SohaNiroomand/Discrete-BJT-Audio-Power-Amplifier/Elec2_Report_Ph2_403170569_English.pdf

Electronics II Project Report: Phase II – Soha Niroomand

# Design and Evaluation Report for the Electronics II Project (Phase II)

Name: Soha Niroomand Student ID: 403170569

## 1 Project Requirements

### Main Phase-II Requirements

In this phase, the completed amplifier must be designed and evaluated as a single integrated circuit containing a differential input stage, voltage-amplification stages, bias networks, a power output stage, the output load, and global negative feedback. The final circuit must satisfy the following requirements:

Required Value | Parameter
50Ω | Output load resistance (RL)
18 ≤ |Av,closed| ≤ 22 Closed-loop gain at 1 kHz
10kΩ to 200kΩ | Allowed range of Rf and Rg
16Vpp | Main output swing without severe clipping
> 60% | Output-stage efficiency at 16Vpp
< 0.08% | THD under normal conditions
< 1% | THD in the presence of the specified noise sources
≤ 190mW | Total power at 50mV and 1 kHz input
> 1MΩ | Differential input resistance (Rin,diff)
< 50Ω | Output resistance (Rout), with RL removed
10mV | Sawtooth supply ripple in the PSRR test
≤ 200 | Maximum circuit cost

### Final Specification Check

The final measured results are summarized below. All main tests were performed on the complete feedback amplifier with RL = 50Ω, except for the output-resistance test, in which the load was removed as required.

Parameter | Requirement | Measured Value | Status
|Av,closed| | 18 to 22 | 20.877 | PASS
Vout,pp | at least 16Vpp | 16.050Vpp | PASS
ηout | > 60% | 63.33% | PASS
Ptotal at 50mV input | ≤ 190mW | 163.759mW | PASS
Normal THD | < 0.08% | 0.040374% | PASS
THD with noise | < 1% | 0.819073% | PASS
PSRR | report the value | 45.429dB | –
Rin,diff | > 1MΩ | 32.479MΩ | PASS
Rout | < 50Ω | 0.2135Ω | PASS
Cost | ≤ 200 | 190 | PASS

## 2 Final Circuit and Overall Architecture

### Required Work (Part 1)

Introduce the final project circuit and state that only one complete final amplifier is submitted. The circuit must include the differential input, voltage-amplification stages, bias circuits, power output stage, RL = 50Ω load, and global negative-feedback network. Also explain the order of completion: first adding the output stage and then closing the global feedback loop.

### Selected Final Architecture

The final design is a multistage amplifier powered from symmetric ±10V supplies and implemented as one integrated circuit. Its overall structure consists of the input differential pair Q1–Q2, active loads and current mirrors, voltage-amplification stages Q6 through Q10, bias networks, a complementary class-AB output stage, and a resistive global-feedback network.
The output stage is formed by the complementary emitter followers Q13 and Q16 and is driven and biased by Q10, Q11, Q12, Q17, and Q18. The bias voltage between the two output-transistor bases is set close to two base-emitter drops, thereby reducing crossover distortion. The 50Ω load is connected directly to the final output node.
The output voltage is sampled by Rf = 200kΩ and returned to the base of Q1. Resistor Rg = 10kΩ connects the same node to ground, while the external input is applied to the base of Q2; therefore, the overall configuration is non-inverting. The power output stage was connected and biased first, and the global feedback loop was closed only after the output stage had been adjusted.
A compensation capacitor C1 = 82pF was placed around the Q10 voltage-amplification stage to improve loop stability and suppress undesired high-frequency components. Compared with Phase I, the principal additions are the power stage, the class-AB bias network, the 50Ω load, global negative feedback, and Miller compensation.

### Complete Final Schematic

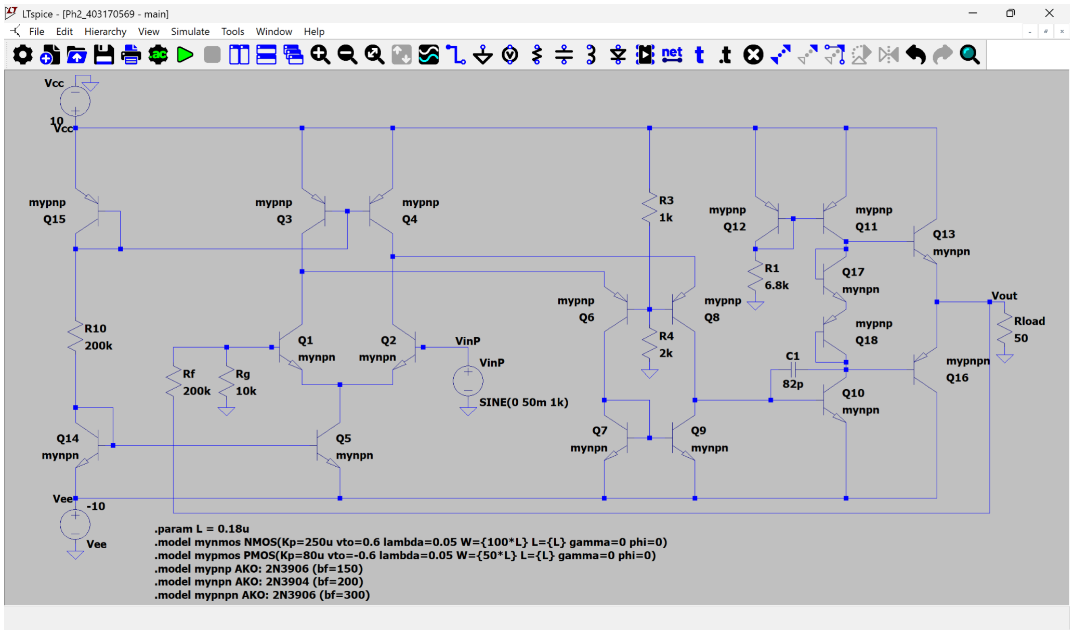
[picture p1: figure]

Figure 1 – Complete final schematic including the power stage, 50Ω load, global feedback, and the 82pF compensation capacitor.

The principal final values are Rf = 200kΩ, Rg = 10kΩ, R1 = 6.8kΩ, R3 = 1kΩ, R4 = 2kΩ, R10 = 200kΩ, and C1 = 82pF.

## 3 DC Analysis and Biasing of the Final Circuit

### Required Work (Part 2)

Perform a DC analysis of the final circuit. Evaluate the operating points of the principal stages, the bias currents, important node voltages, and the output-stage bias condition. If a VBE multiplier or an equivalent network is used, report its bias voltage.

### Theoretical Bias Calculations

The operating-point analysis was performed with zero input and a 50Ω load. From the DC results, the reference current in the left branch is

IR10 = 94.06 µA.

The tail current of the differential pair, supplied by Q5, is approximately 101.35 µA and is divided as
IC,Q1 = 53.64 µA, IC,Q2 = 47.24 µA. The small mismatch is caused by input bias currents and the closed-loop offset.
For the middle bias network,

IR3 =

10 − 6.667
1k
= 3.333 mA, | IR4 =
| 6.667 2k = 3.333 mA.

The output-stage bias branch current through R1 is approximately

IR1 = 1.373 mA.

At the operating point, the two output-drive node voltages are

VBUP = 0.8025V, VBDN = −0.5277V,

and hence the bias voltage across the output-transistor bases is

Vbias = VBUP − VBDN = 1.3302V.

This is close to two base-emitter junction drops and therefore establishes class-AB operation.
The output offset is Vout,DC = 119.087mV . With the 50Ω load, the DC load current is

IRL,DC =

0.119087
50

= 2.382mA.

The output-transistor collector currents at the operating point are

IC,Q13 = 3.158mA, |IC,Q16| = 0.779mA.

Their difference supplies the DC current delivered to the load.

### DC Operating-Point Simulation Results

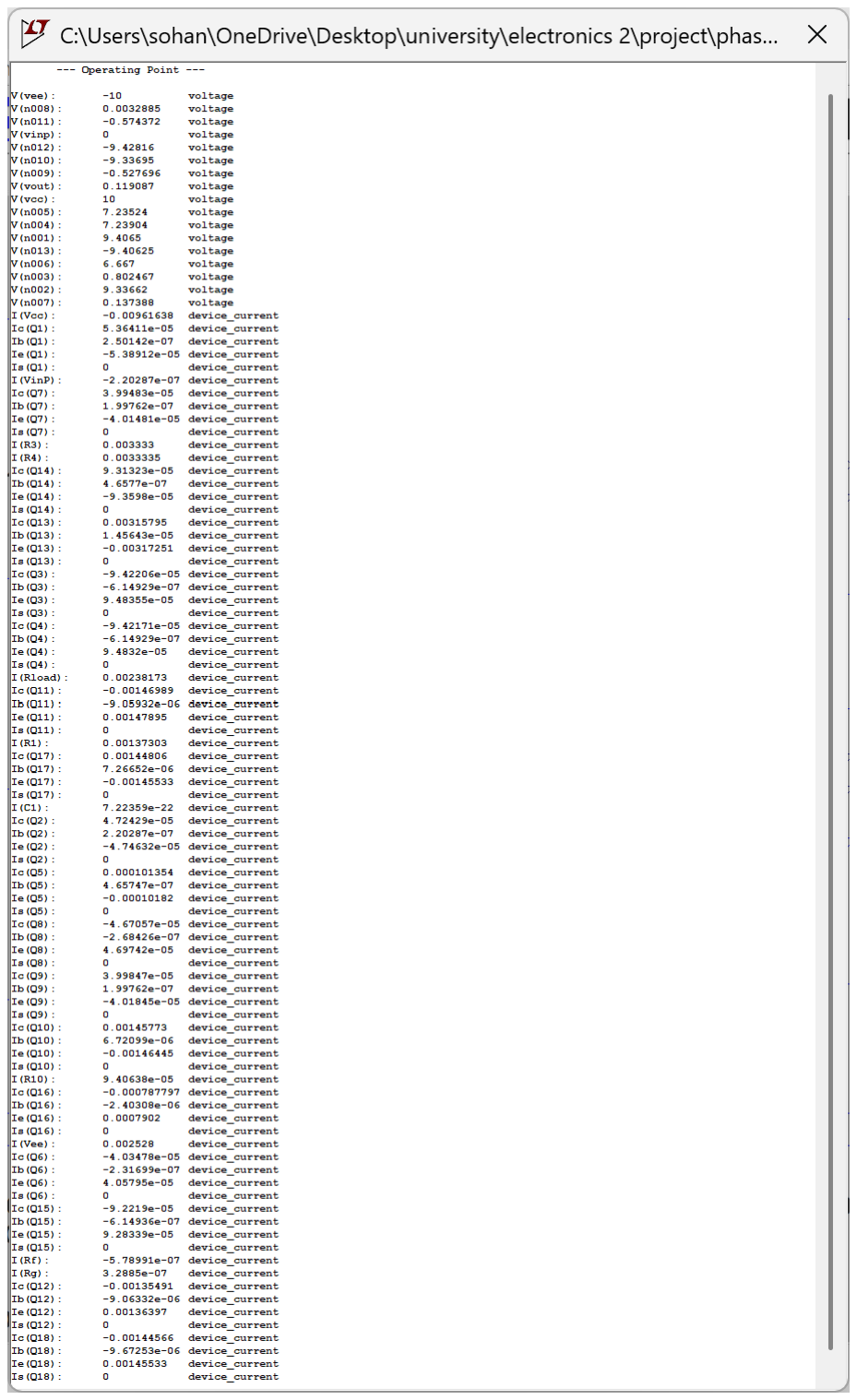
[picture p2: figure]

Figure 2 – LTspice DC operating-point results for the final circuit with zero input.

Important results:

- Output DC voltage at zero input: Vout,DC = 0.119087V .
- Quiescent output-transistor currents: IC,Q13 = 3.158mA and |IC,Q16| = 0.779mA.
- DC load current: 2.382mA.
- Output-stage bias voltage: 1.330V .
- Positive-supply current at the operating point: approximately 9.616mA; negativerail branch current: approximately 2.528mA.

All gain-stage transistors operate in their active regions. The two-junction output bias creates a small overlap in conduction around the zero crossing and reduces crossover distortion. The approximately 119mV output offset does not violate any mandatory specification.

## 4 Power Output-Stage Design

### Required Work (Part 3)

Introduce and analyze the power output stage. Show that it is connected integrally to the main amplifier and is designed to drive the 50Ω load. Explain its topology, transistor types, biasing, and the reasons for selecting this structure.

### Theoretical Output-Stage Analysis

To generate a 16Vpp output across 50Ω, the required voltage and current peaks are

Vp =

16
2

= 8V, IL,p =

Vp
RL

=

8
50

= 160mA.

The corresponding RMS voltage and theoretical load power are

VL,rms =

8
√
2

= 5.657V, PL =

V

2
L,rms
50

= 0.64W.

A complementary emitter-follower stage was selected because it provides high current gain, low output resistance, and a voltage swing close to the supply rails. The theoretical maximum efficiency of an ideal class-B sinusoidal stage is

ηB,max =

π
4

× 100% = 78.5%.

In practice, class-AB quiescent current, base-emitter drops, and driver losses reduce the attainable efficiency.
Assuming a current gain of approximately 200, the worst-case output-transistor peak base current is

IB,p ≃

160mA
200

= 0.8mA,

which can be supplied by the driver network with its approximately 1.4mA bias current.

### Output-Stage Structure and Evaluation

The output stage is a complementary class-AB push-pull emitter follower. Q13 is the upper NPN device and Q16 is the lower PNP device; their emitters are joined at Vout. The stage has approximately unity voltage gain but provides the current required by the low-resistance load.
The voltage-amplification-stage output is conveyed through Q10 and the Q11–Q12 current mirror to the Q17–Q18 bias network. This network establishes approximately 1.33V between the bases of Q13 and Q16, thereby reducing the crossover dead zone. The output PNP device uses a 2N3906-based model with βF = 300, which is within the permitted use of one different transistor model.
Capacitor C1 = 82pF is connected between the input and output of the inverting Q10 voltage-amplification stage and acts as a Miller compensation capacitor. It lowers loop gain before non-dominant poles introduce excessive phase lag, thereby improving phase margin, transient damping, and overall stability. The driver network was also designed to preserve sufficient voltage headroom for an approximately ±8V output and sufficient base current for the 160mA load-current peak.

### Mathematical Design and Selection of the Miller Compensation Capacitor

The capacitor C1 is connected between the base and collector of Q10. Since this is an inverting gain stage, let its small-signal voltage gain be

A2 =

vc10

vb10

< 0.

The current drawn by the capacitor from the input side is

iC = C1

d(vb10 − vc10)
dt | = C1(1 − A2)

dvb10
dt .

Therefore, by Miller’s theorem, the effective capacitance seen at the input of the voltage-amplification stage is approximately

CM,in = C1(1 − A2) ≃ C1(1 + |A2|),

whereas the effective capacitance at the output side is approximately

CM,out = C1

(
1 −

1
A2

)
≃ C1.

Consequently, the dominant pole associated with the input of Q10 moves to a lower frequency:

fp1 ≃

1
2πRin,V AS [Cπ,Q10 + C1(1 + |A2|)].

This produces pole splitting: around the loop crossover frequency, the loop gain is dominated by one pole and falls at approximately −20dB/dec. Thus, the loop gain reaches unity before the additional phase lag from non-dominant poles can cause ringing or oscillation.
For a first-order estimate of C1, the standard two-stage compensated-amplifier relation is used:
fu ≃

gm,in
2πC1

,

where fu is the loop unity-gain frequency and gm,in is the effective transconductance of the input stage. From the operating point,

IC,Q1 = 53.64 µA, VT ≃ 25.9mV,

so

gm,in ≃

IC,Q1
VT

=

53.64 µA
25.9mV
| = 2.07mS.

The measured closed-loop gain is ACL = 20.877. To keep the closed-loop bandwidth at roughly ten times the highest audio frequency of 20kHz, the target was selected as

fBW,CL ≃ 200kHz.

Using fBW,CL ≃ fu/ACL gives

C1,calc ≃

gm,in

2πACLfBW,CL

=

2.07mS
2π(20.877)(200kHz)

= 78.9pF.

The nearest standard and readily available value is therefore

C1 = 82pF .

With this value,
fu ≃

2.07mS
2π(82pF)

= 4.02MHz,

fBW,CL ≃

4.02MHz
20.877

= 192.5kHz.

Thus, the estimated closed-loop bandwidth is approximately 9.6 times 20kHz, which comfortably covers the audio band with little attenuation.
The compensation capacitor also limits slew rate. Using the differential-pair tail current,

Itail ≃ 101.35 µA,

the first-order available slew rate is

SRavailable ≃

Itail
C1

=

101.35 µA
82pF

= 1.24 V /µs.

For a full-amplitude sinusoid with 8V peak at 20kHz, the minimum required slew rate is

SRrequired = 2πfmaxVp = 2π(20kHz)(8V ) = 1.01 V /µs.

Therefore, 82pF still provides sufficient slew-rate margin for a full-amplitude 20kHz signal. Equivalently, the approximate maximum acceptable capacitor from the slew-rate condition is

C1,max ≃

Itail

SRrequired

= 100.8pF.

Hence, 82pF lies in a suitable range according to both bandwidth and slew-rate constraints.
The effect of changing the capacitor can be summarized as follows:
- A smaller C1 increases bandwidth and slew rate, but moves the loop crossover closer to non-dominant poles, reduces phase margin, and increases the probability of ringing, oscillation, and elevated noise-related THD.
- An excessively large C1 improves stability and attenuates high-frequency components, but reduces bandwidth, transient speed, and the ability to reproduce full-amplitude high-frequency audio signals.
- The selected 82pF value is a compromise between these effects. It yields stable transient behavior, T HD = 0.040374% without noise, and T HD = 0.819073% with the specified noise sources, while maintaining the required gain, swing, and efficiency.

## 5 Application of Global Negative Feedback

### Required Work (Part 4)

After adding the output stage, apply global negative feedback around the complete amplifier. The feedback signal must be sampled from the final output and returned to the differential input. The principal feedback network must contain only Rf and Rg, and the closed-loop gain should be approximately 20.

### Feedback-Network Calculations

The closed-loop configuration is non-inverting. Assuming sufficiently large open-loop gain,

Av,CL ≃ 1 +

Rf
Rg

With
Rf = 200kΩ, Rg = 10kΩ,

we obtain
Av,CL,ideal = 1 + | 200k 10k = 21.

Both resistors lie within the allowed 10kΩ to 200kΩ range. The feedback factor is

β =

Rg
Rf + Rg

=

1
| 21 = 0.04762.

In the standard simulation, 0.1Vpp was applied and 2.08775Vpp was measured at the output, so

|Av,CL| =

2.08775
0.1 | = 20.8775,

or
20 log10 |Av,CL| = 26.39dB.

The error relative to the ideal value is only about 0.58%.

### Feedback Results

Final values and connections:

- Rf = 200kΩ.
- Rg = 10kΩ.
- Sampling point: final Vout node, after the power stage and in the presence of the load.
- Feedback injection point: base of Q1; the base of Q2 is the signal input.
- Closed-loop gain at 1kHz: |Av| = 20.8775 or 26.39dB.

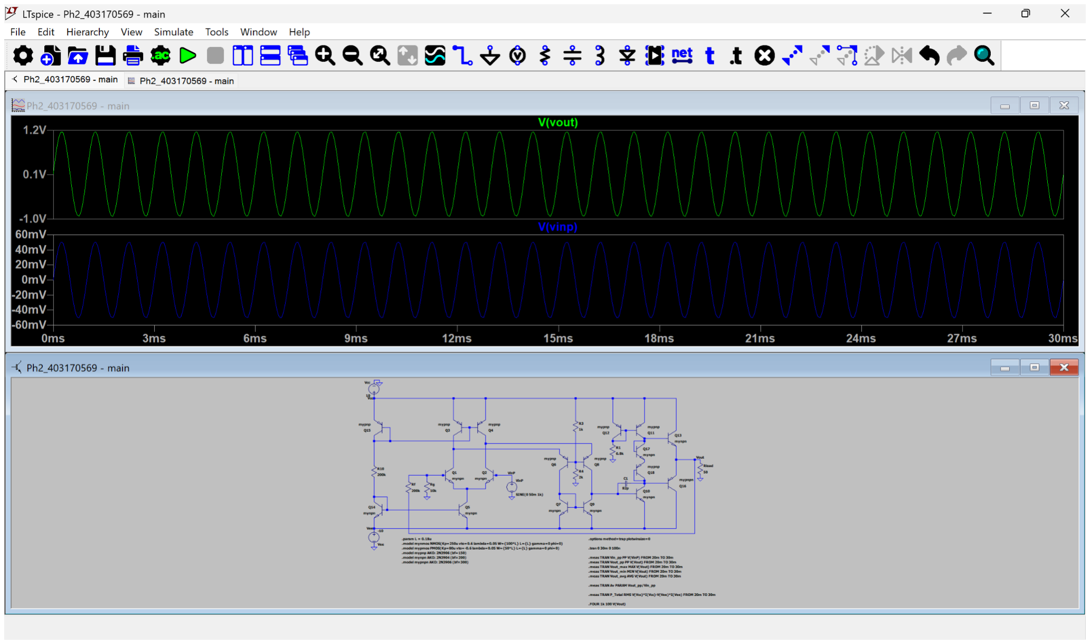
[picture p3: figure]

Figure 3 – Input and output waveforms under the standard condition: Vin = 50mVpeak and f = 1kHz.

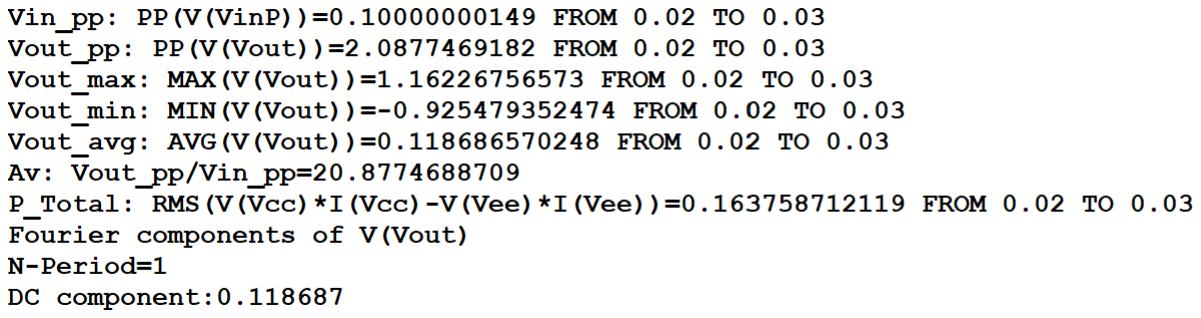
[picture p4: figure]

Figure 4 – Measured gain, output offset, and total power under the standard test condition.

The output is sinusoidal and in phase with the input, with an amplitude approximately 20.88 times larger. The measured gain lies within the permitted range of 18 to 22.

## 6 Comparison With and Without Feedback

### Required Work (Part 5)

Compare the complete circuit with global feedback and without global feedback. The output stage must remain connected in both cases. If the no-feedback circuit saturates, explain why the measured amplitude ratio is not a valid estimate of linear open-loop gain.

### Qualitative and Quantitative Comparison

For the no-feedback test, Rf and Rg were removed from the loop and the base of Q1 was connected directly to ground, while the output stage and the 50Ω load remained connected. The input in both tests was 50mVpeak at 1kHz.
With feedback, the output remains sinusoidal with Vout,pp = 2.0877V and a gain of 20.877.

Without feedback, the very large open-loop gain drives the output into saturation at approximately +9V and −9V even for this small input, producing an almost square waveform. The ratio of the saturated output amplitude to the input amplitude is not a valid estimate of linear open-loop gain because the output is limited by the supply rails.

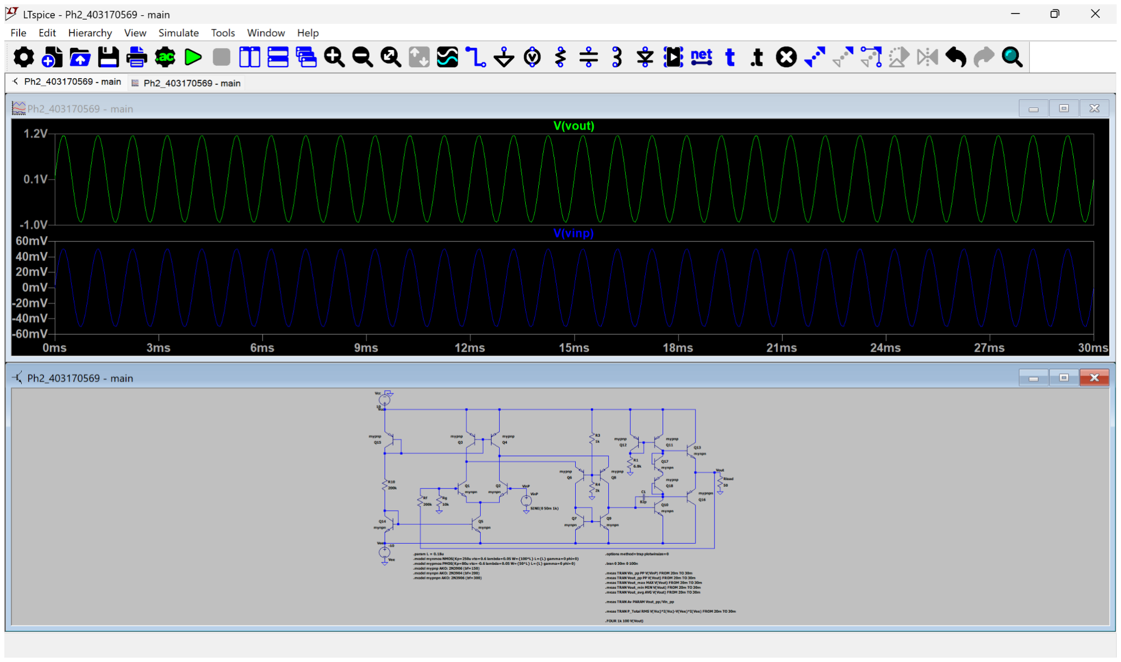
[picture p5: figure]

Figure 5 – Amplifier with feedback: linear sinusoidal output for the standard input.

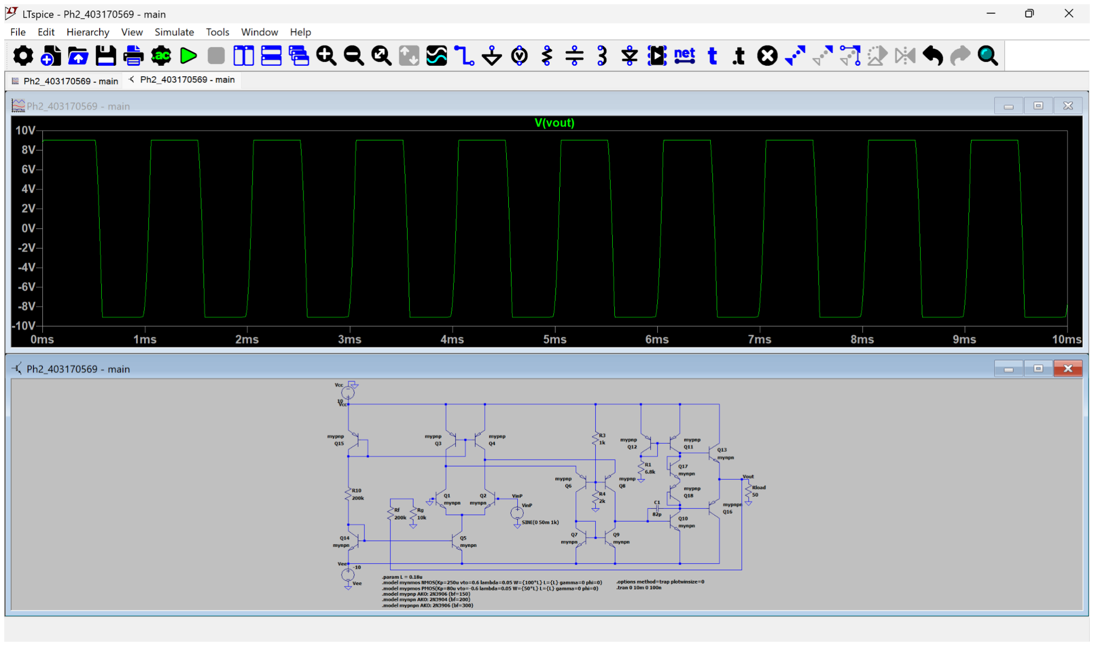
[picture p6: figure]

Figure 6 – Amplifier without feedback: severe saturation and clipping for the same input amplitude.

Negative feedback fixes the gain at a predictable value, improves linearity, reduces distortion, and increases the input amplitude required to reach clipping. Without feedback, the amplifier leaves its linear region even for a 50mV input.

## 7 Output Swing, Power, and Efficiency

### Required Work (Part 6)

Determine whether the final amplifier can produce a 16Vpp sinusoidal output across 50Ω without severe clipping or visible distortion. Then measure the load power, total circuit power, and output-stage efficiency.

### Theoretical Swing and Efficiency Calculations

With ±10V supplies, transistor and driver voltage drops imply that the output peak will be somewhat below each rail. The target Vp = 8V leaves approximately 2V of headroom from each supply and is therefore attainable with the emitter-follower topology.
For Vout,pp = 16V and RL = 50Ω,

PRL,th =

(Vpp/2√
2)²
RL

=

(16/2√
2)²
50

= 0.64W.

Because the closed-loop gain is close to 21, the theoretical required input peak is

Vin,p ≃

8
21

= 0.381V.

A value of 385mV was used in simulation. The output-stage efficiency was calculated as

ηout =

PRL

PQ13 + PQ16

× 100%.

### Transient and Power-Measurement Results

For Vin,p = 385mV at 1kHz, the results were

Vin,pp = 0.7700V,
Vout,pp = 16.0501V,
Vout,max = 8.1392V,
Vout,min = −7.9109V,
Av = 20.8443.

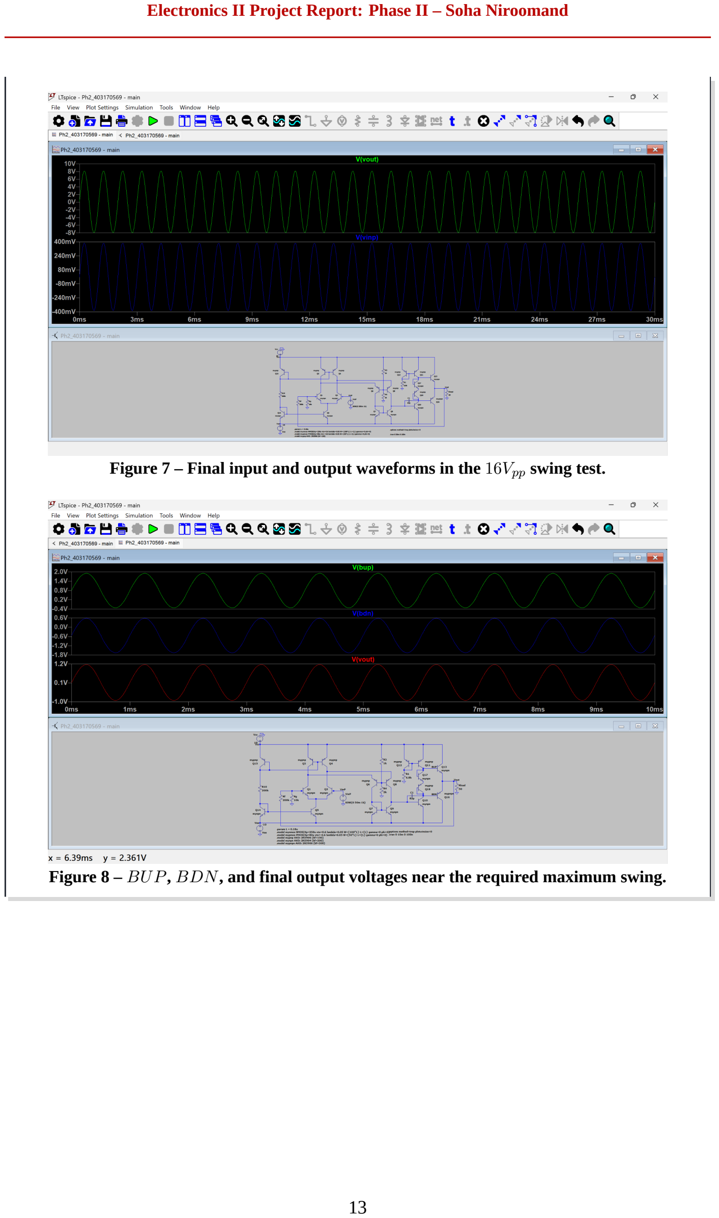
[picture p7: page 13]

Figure 7 – Final input and output waveforms in the 16Vpp swing test.

Figure 8 – BUP, BDN, and final output voltages near the required maximum swing.

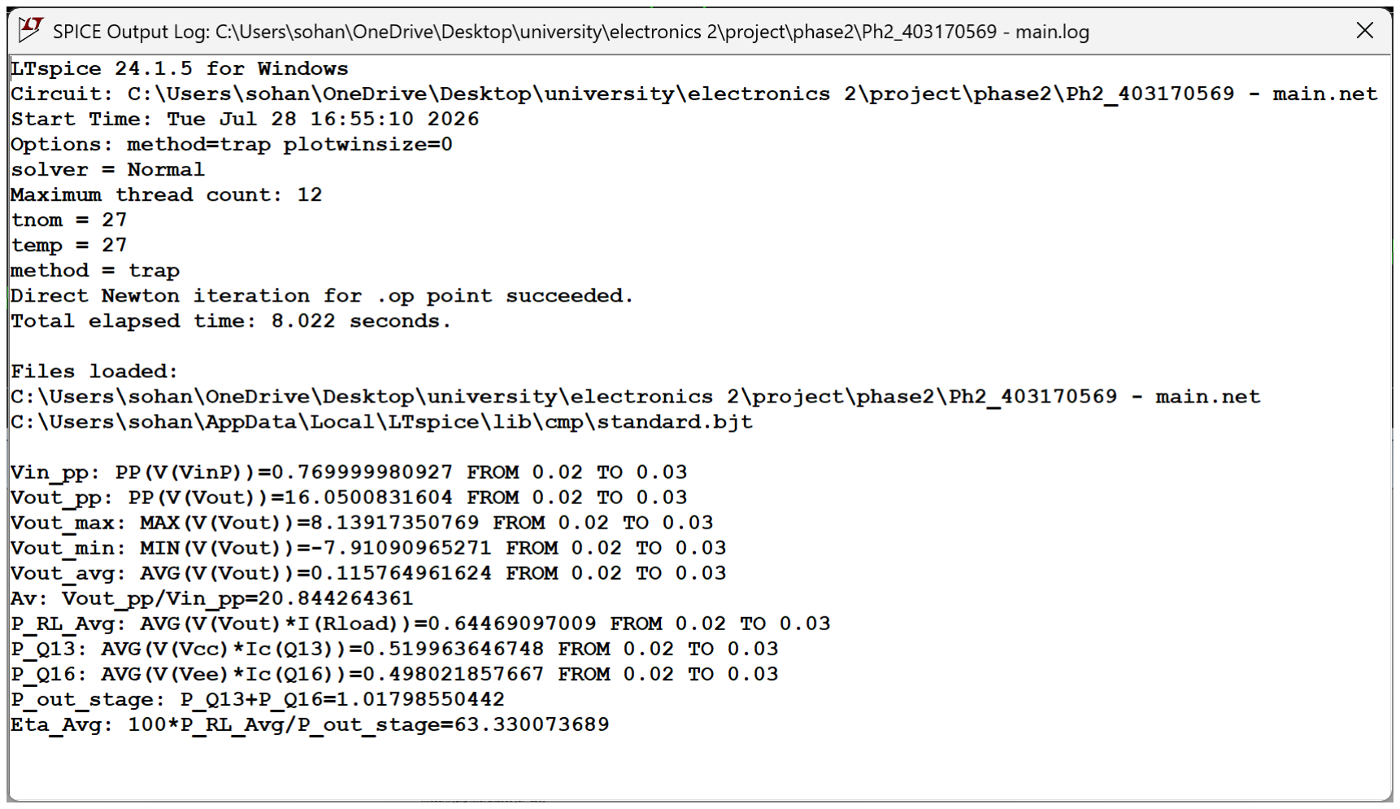
[picture p8: figure]

Figure 9 – Numerical measurements of amplitude, load power, and output-stage efficiency.

Measured values:

- Required input amplitude: 385mVpeak.
- Average load power: PRL = 0.644691W.
- Total circuit power at this operating point: Ptotal ≃ 1.138W.
- Upper output transistor power: PQ13 = 0.519964W.
- Lower output transistor power: PQ16 = 0.498022W.
- Total output-stage power: Pout−stage = 1.017986W.
- Efficiency: ηout = 63.330%, so the 60% requirement is satisfied.

The output remains essentially sinusoidal at this amplitude and no severe clipping is visible. The slight asymmetry between the positive and negative peaks is associated with the DC offset and mismatch between complementary device models. Global feedback shifts the onset of clipping to a substantially larger input amplitude than in the open-loop case. Main LTspice measurement directives:

1 | .meas TRAN Vin_pp PP V(VinP) FROM 20m TO 30m
2 | .meas TRAN Vout_pp PP V(Vout) FROM 20m TO 30m
3 | .meas TRAN P_RL_Avg AVG V(Vout)*I(Rload) FROM 20m TO 30m
4 | .meas TRAN P_Q13 AVG V(Vcc)*Ic(Q13) FROM 20m TO 30m
5 | .meas TRAN P_Q16 AVG V(Vee)*Ic(Q16) FROM 20m TO 30m
6 | .meas TRAN P_out_stage PARAM P_Q13+P_Q16
7 | .meas TRAN Eta_Avg PARAM 100*P_RL_Avg/P_out_stage

## 8 Total Power Under the Standard Input Condition

### Required Work (Part 7)

For a 50mV -peak, 1 kHz sinusoidal input, measure the total power consumed by the final circuit and compare it with
Ptotal ≤ 190mW.

### Power Measurement Under the Standard Condition

The test was performed with Vin = 50mVpeak, f = 1kHz, ±10V supplies, and RL = 50Ω. Total power was calculated from both supply rails over the steady-state interval from 20ms to 30ms.

Parameter | Value
Input amplitude | 50mVpeak
Input frequency | 1kHz
Vout,pp | 2.08775V
Total circuit power | 0.163759W = 163.759mW
Status | PASS

Figure 10 – Total circuit-power measurement for the standard input.

Since 163.759mW < 190mW, the power-consumption requirement is satisfied with approximately 26.24mW of margin.

## 9 Total Harmonic Distortion Measurement

### Required Work (Part 8)

Measure the THD of the final feedback amplifier with the output stage and 50Ω load connected. Use a 50mV -peak, 1 kHz sinusoidal input. Repeat the test after inserting the specified noise sources in series with the resistors that set the current-source values.

### Measurement Method and Interpretation

To remove start-up transients, the transient simulation was run to 30ms and Fourier analysis was performed on the steady-state waveform. The maximum time step was 100ns and waveform compression was disabled:

1 | .options method=trap plotwinsize=0
2 | .tran 0 30m 0 100n
3 | .FOUR 1k 100 V(Vout)

In the noisy test, four behavioral sources described by

1 V=(white(2e6*time)/4)

were inserted in series with R10, R3, R4, and R1. These resistors set the currents of the input current source, middle stage, and output-bias network.
The added noise randomly modulates the bias currents and creates incoherent spectral components at the output; therefore, the reported total distortion increases. Nevertheless, negative feedback suppresses part of this disturbance.

### THD Results

Test Condition | THD | Status
Feedback amplifier, no noise | 0.040374% | PASS
Feedback amplifier, with noise sources | 0.819073% | PASS

Figure 11 – Fourier table and THD of the final circuit without the added noise sources.

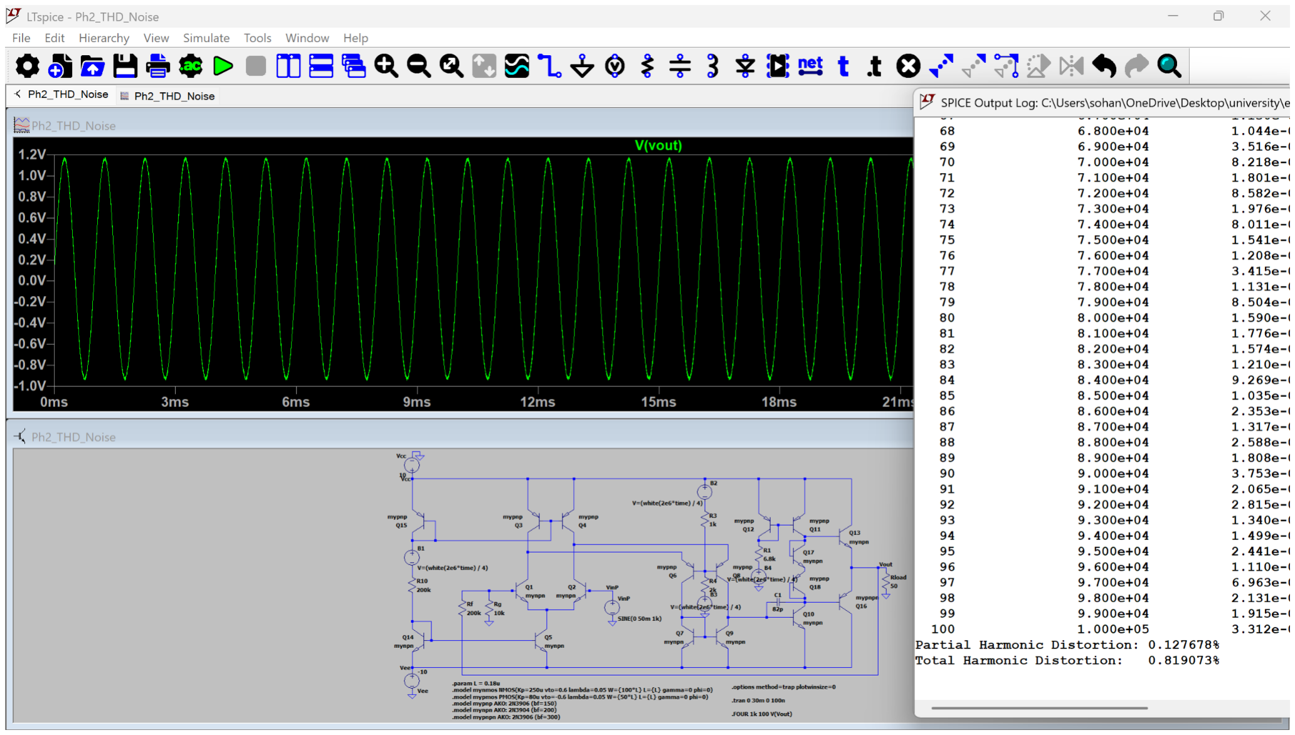
[picture p9: figure]

Figure 12 – Noisy circuit, output waveform, and measured THD = 0.819073%.

Without added noise, the second and higher harmonics are extremely small and the THD is approximately 0.0404%. With the noise sources, the total value increases to 0.8191%, which still remains below the 1% limit. In the noisy test, partial harmonic distortion was 0.127678%, while the reported total including noise components was 0.819073%.

## 10 PSRR Measurement With Sawtooth Supply Ripple

### Required Work (Part 9)

Set the signal input to zero and evaluate how supply ripple appears at the output. Use sawtooth sources with 10mV ripple for both VCC and VEE, and calculate
P SRR = 20 log (
Vripple

∆Vout)

### Test Method and PSRR Calculation

For the PSRR test, the input was set to zero and the DC supplies were replaced by

1 | PWL(0 12 5m 12.01 10m 12 15m 12.01 20m 12)
2 | PWL(0 -12 5m -12.01 10m -12 15m -12.01 20m -12)

The ripple was defined peak-to-peak, so for each rail

Vripple,pp = 10.00002mV.

The output peak-to-peak variation from 10ms to 20ms was

∆Vout,pp = 5.352497 × 10−5V = 53.525µV.

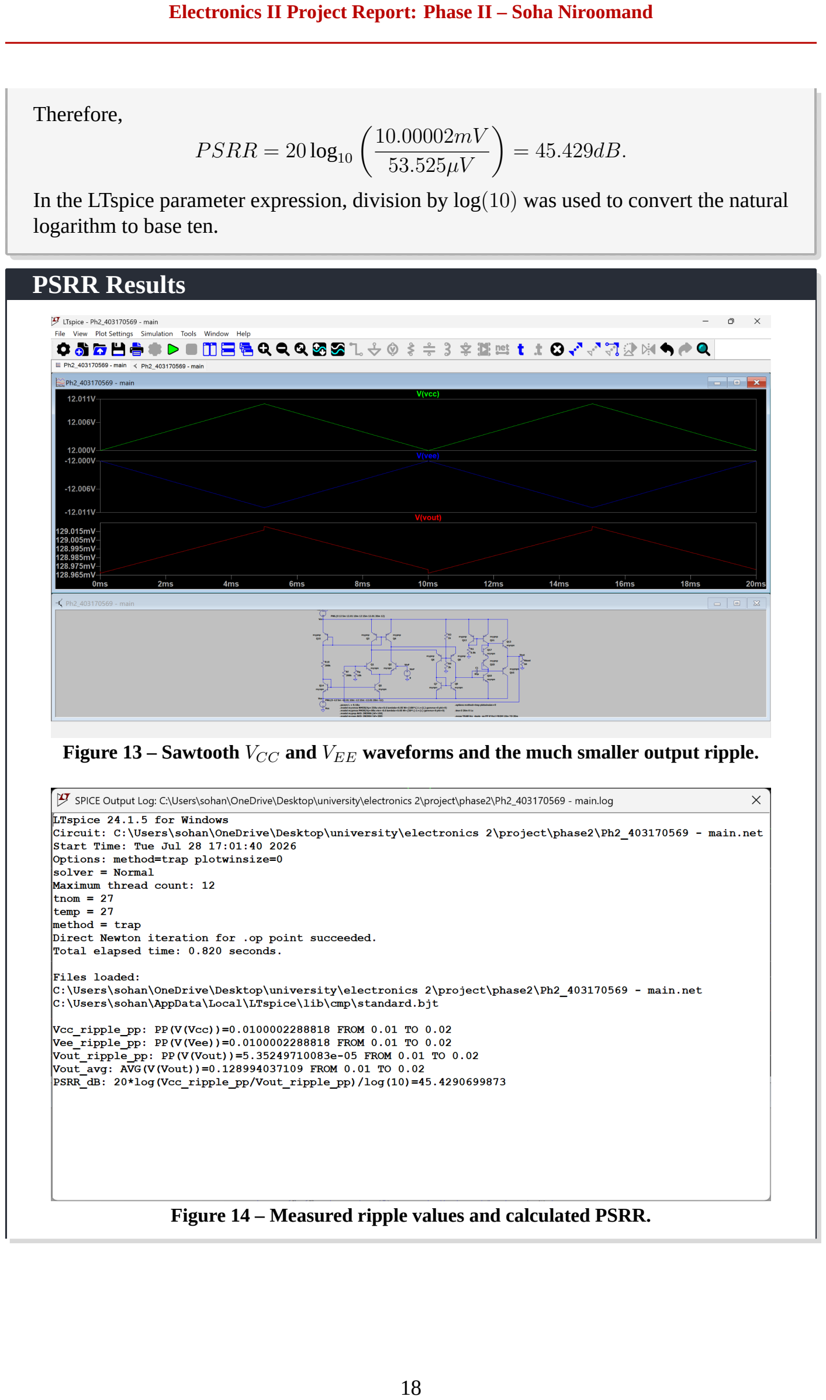
[picture p10: page 18]

Therefore,
P SRR = 20 log10 (
10.00002mV

53.525µV )
= 45.429dB.

In the LTspice parameter expression, division by log(10) was used to convert the natural logarithm to base ten.

### PSRR Results

Figure 13 – Sawtooth VCC and VEE waveforms and the much smaller output ripple.

Figure 14 – Measured ripple values and calculated PSRR.

Parameter | Value
Vripple,pp on each rail | 10.00002mV
∆Vout,pp | 53.525µV
Vout,avg | 128.994mV
PSRR | 45.429dB

The output ripple is approximately 187 times smaller than the applied ripple. Thus, at the selected ripple frequency the amplifier strongly suppresses simultaneous changes on the two supply rails. The DC output offset was excluded from the PSRR calculation; only the output peak-to-peak variation was used.

## 11 Differential Input-Resistance Measurement

### Required Work (Part 10)

Measure the differential input resistance of the final circuit and compare it with

Rin,diff > 1MΩ.

Explain the measurement procedure.

### Analytical Estimate and Measurement Method

In the small-signal model, each input transistor has an approximate base resistance

rπ =

βVT
IC

For β ≃ 200 and a collector current of roughly 47µA, the intrinsic value is approximately 110kΩ. Global negative feedback keeps the differential input voltage very small and raises the effective closed-loop input resistance by the loop-gain factor, so a value of several tens of megaohms is expected.
For the precise result, LTspice transfer-function analysis was used. LTspice calculates the small-signal input-source current and reports

Rin =

Vtest

Itest

### Input-Resistance Simulation Result

The final circuit was simulated with RL = 50Ω and zero DC input using

1 .tf V(Vout) VinP

The V inP source applies the small-signal excitation to the non-inverting input of the differential pair, while the other input is established by the feedback network.

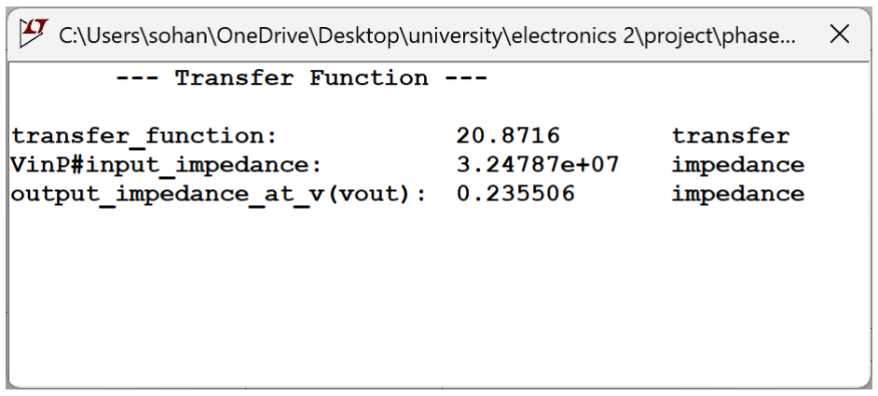
[picture p11: figure]

Figure 15 – Transfer-function result used to determine the final amplifier input resistance.

- Small-signal gain: 20.8716.
- Effective input resistance: Rin,diff = 3.24787 × 10⁷Ω = 32.4787MΩ.
- Status: PASS, because 32.4787MΩ > 1MΩ.

## 12 Output-Resistance Measurement

### Required Work (Part 11)

Remove RL, measure the final circuit output resistance, and compare it with

Rout < 50Ω.

Explain how the value is extracted from simulation.

### Analytical Interpretation

The open-loop output resistance of a complementary emitter follower is on the order of the output-device 1/gm values and driver resistances. Global feedback reduces this resistance approximately by the loop factor:

Rout,CL ≃

Rout,OL
1 + T

Thus, the closed-loop value is expected to be much less than 50Ω. The load must be removed so that the external 50Ω resistance is not placed in parallel with the amplifier’s intrinsic output resistance.

### Output-Resistance Simulation Result

The load was removed completely, the input was set to zero, and the supplies were fixed at ±10V . The same transfer-function analysis was then run:

1 .tf V(Vout) VinP

LTspice applies an internal test source at the output node and reports the voltage-to-current ratio.

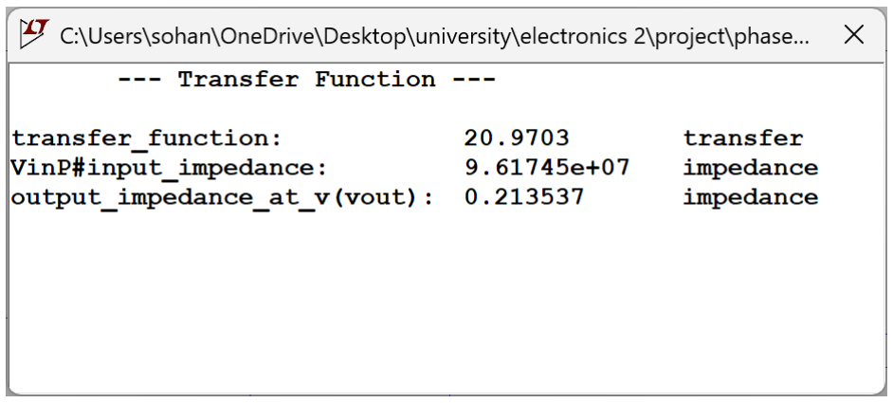
[picture p12: figure]

Figure 16 – Output-resistance result after removing RL.

- Rout = 0.213537Ω.
- Unloaded small-signal gain in this analysis: 20.9703.
- Status: PASS, because 0.213537Ω ≪ 50Ω.

## 13 Real Audio-Signal Amplification Test

### Required Work (Part 12)

Apply a real audio file to the amplifier input and examine the amplified output. A simple sinusoid is not acceptable in place of a real audio signal. Include time-domain input and output waveforms and demonstrate that the output is not severely clipped.

### Audio-File Preparation

The original signal was a personal recording named Soha_audio.m4a, encoded in AAC at 48kHz and two channels. For LTspice, it was converted to

- simulation input filename: audio.wav;
- mono, 16-bit PCM;
- sample rate: 44100Hz;
- duration: 2.665s;
- normalized amplitude of approximately 40mVpeak to avoid output clipping.

The input source and output-file directive were

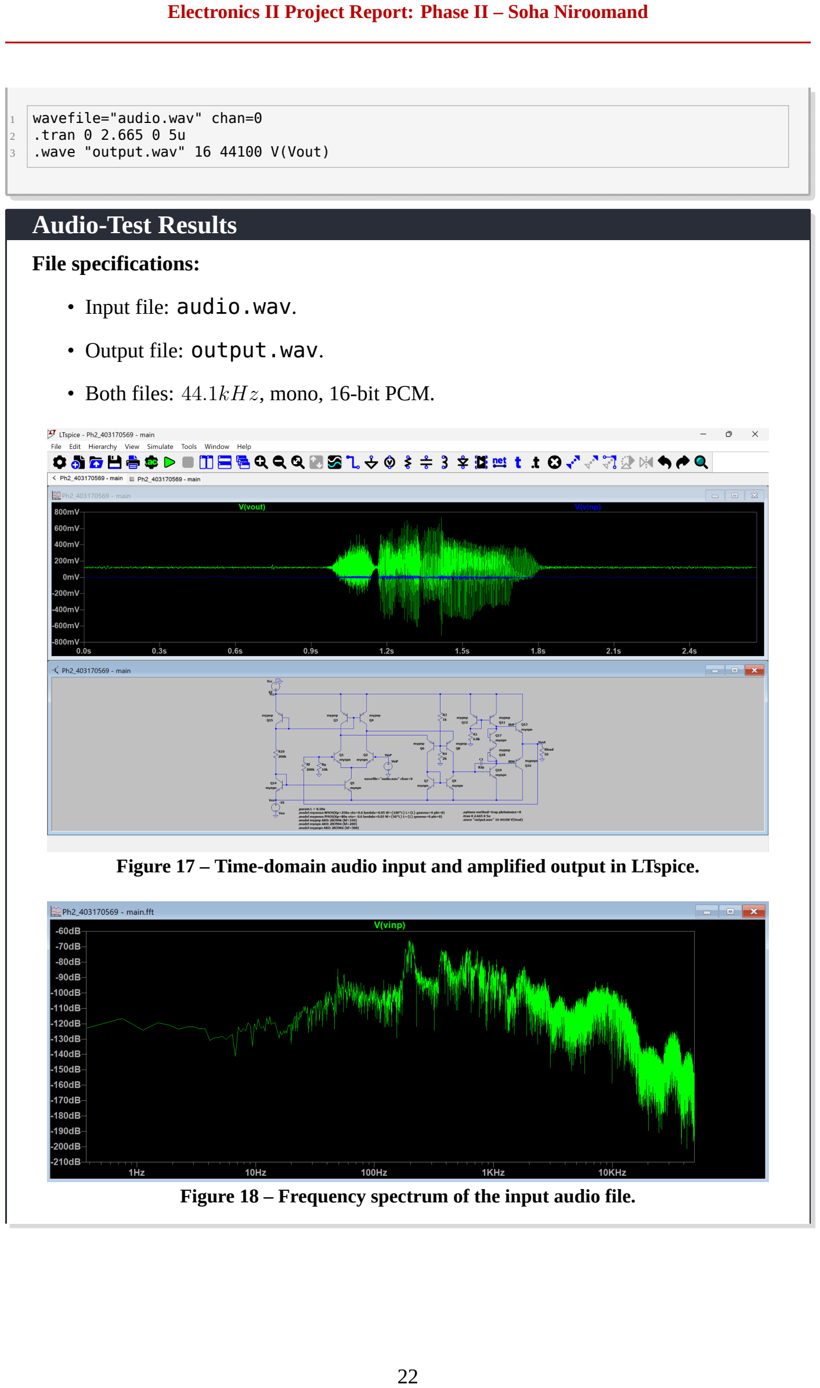
[picture p13: page 22]

1 | wavefile="audio.wav" chan=0
2 | .tran 0 2.665 0 5u
3 | .wave "output.wav" 16 44100 V(Vout)

### Audio-Test Results

File specifications:

- Input file: audio.wav.
- Output file: output.wav.
- Both files: 44.1kHz, mono, 16-bit PCM.

Figure 17 – Time-domain audio input and amplified output in LTspice.

Figure 18 – Frequency spectrum of the input audio file.

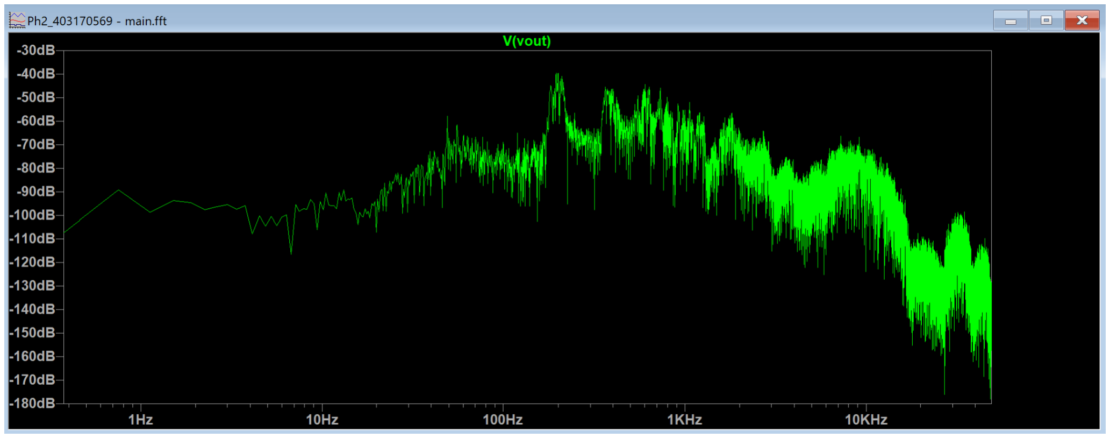
[picture p14: figure]

Figure 19 – Frequency spectrum of the amplified output file.

Numerical analysis of the WAV files showed an output range from −0.716V to +0.734V , far from either the digital full-scale limit or the circuit supply rails; therefore, severe clipping is absent. The output mean is 0.119V , and a linear fit between the two files gives a gain of 20.838, or 26.38dB. The input-output correlation coefficient is approximately 0.9999, and the two spectra retain the same overall shape. Their level difference is approximately equal to the circuit gain, indicating that the principal audio-frequency components are preserved.
Files submitted for this part: audio.wav and output.wav.

## 14 Circuit Cost and Component Constraints

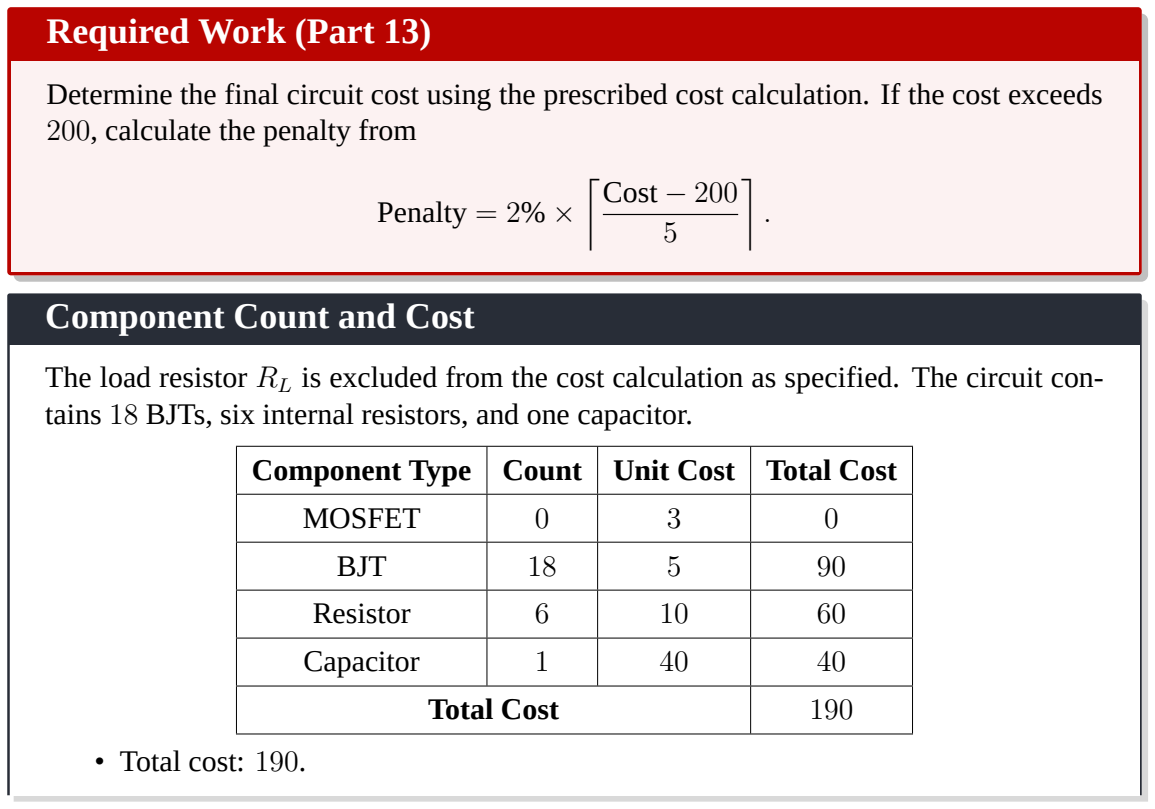
[picture p15: figure]
Required Work (Part 13); 200, calculate the penalty from; Penalty = 2% ×; Cost − 200; Component Count and Cost; Component Type; Count; Unit Cost; Total Cost; MOSFET; BJT; Resistor; Capacitor; • Total cost: 190.

Determine the final circuit cost using the prescribed cost calculation. If the cost exceeds

The load resistor RL is excluded from the cost calculation as specified. The circuit contains 18 BJTs, six internal resistors, and one capacitor.

- Exceeds the 200 limit: no.
- Penalty: 0%.

The circuit therefore satisfies the project cost limit with a margin of 10 cost units.

## 15 Optional Bonus Conditions

### Required Work (Part 14)

The optional measurements are evaluated at a single large-signal operating point. The reported quantities are the output swing, the corresponding input amplitude, the output-stage efficiency at that same operating point, and the DC output voltage with the signal input set to zero.

### Optional-Bonus Measurements

For the large-signal test, the final amplifier was kept unchanged with VCC = +10V , VEE = −10V , RL = 50Ω, Rf = 200kΩ, Rg = 10kΩ, and C1 = 82pF. The input source was set to
Vin(t) = 0.430 sin(2π × 1000t) V,

which corresponds to

Vin,peak = 430mV, Vin,pp = 0.860V.

The transient measurements were taken from 20ms to 30ms, after the startup transient had decayed.

Parameter | Reference Condition | Measured Value
Output swing | 17Vpp | 17.901Vpp
Output-stage efficiency | > 70% | 70.734%
|Vout,DC| | < 100mV | 119.087mV

The measured positive and negative output extrema were

Vout,max = 9.0547V, Vout,min = −8.8467V,

and therefore

Vout,pp = Vout,max − Vout,min = 9.0547 − (−8.8467) = 17.9014V.

The average power delivered to the load and the average power associated with the two output transistors were measured as

PRL = 0.803750W,

PQ13 = 0.578997W, PQ16 = 0.557298W.

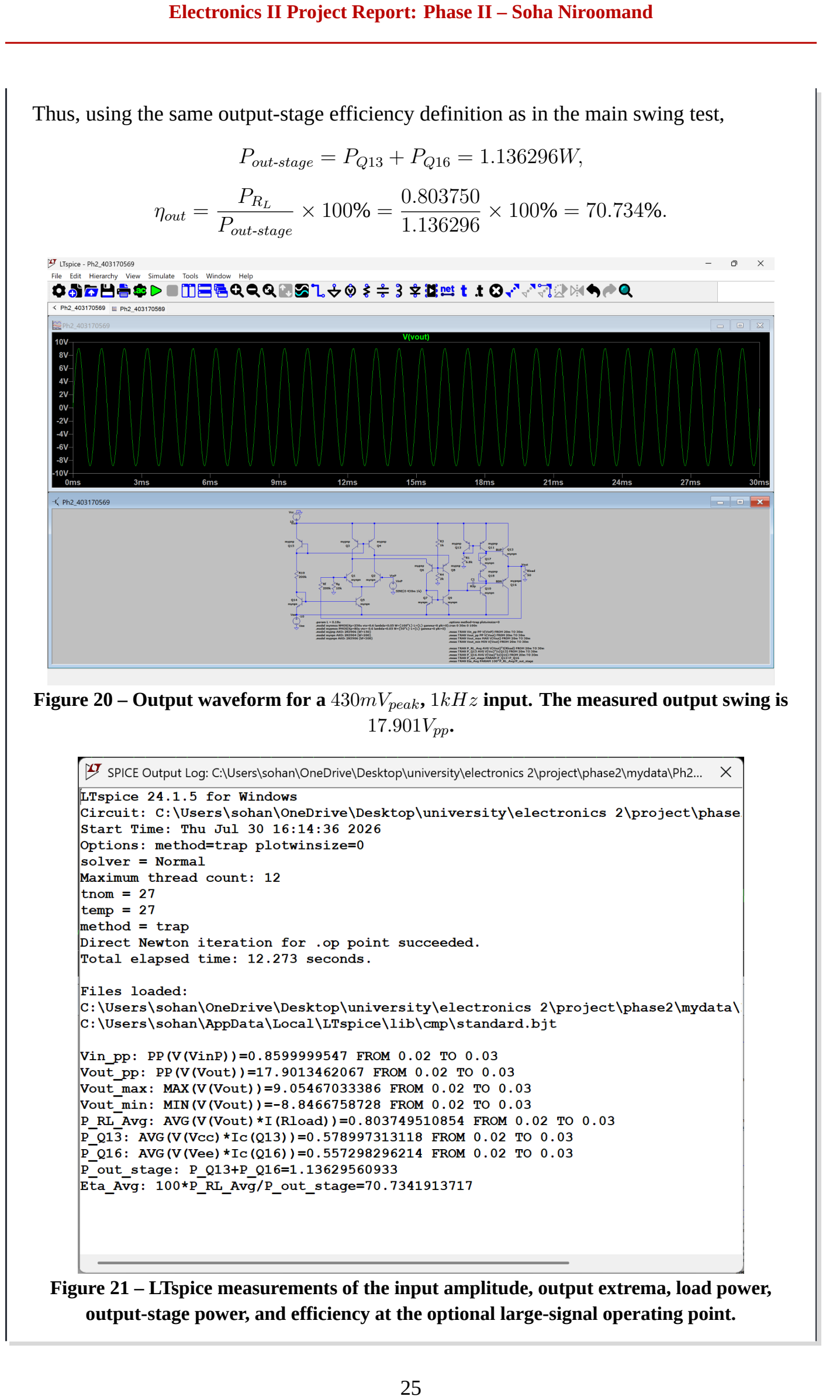
[picture p16: page 25]

Thus, using the same output-stage efficiency definition as in the main swing test,

Pout-stage = PQ13 + PQ16 = 1.136296W,

ηout =

PRL

Pout-stage

× 100% =

0.803750
1.136296

× 100% = 70.734%.

Figure 20 – Output waveform for a 430mVpeak, 1kHz input. The measured output swing is 17.901Vpp.

Figure 21 – LTspice measurements of the input amplitude, output extrema, load power, output-stage power, and efficiency at the optional large-signal operating point.

For the DC-output measurement, the signal source was changed to 0V while the load and the global-feedback network remained connected. The LTspice operating-point result was

Vout,DC = 0.119087V = 119.087mV.

The reported table uses its absolute value:

|Vout,DC| = 119.087mV.

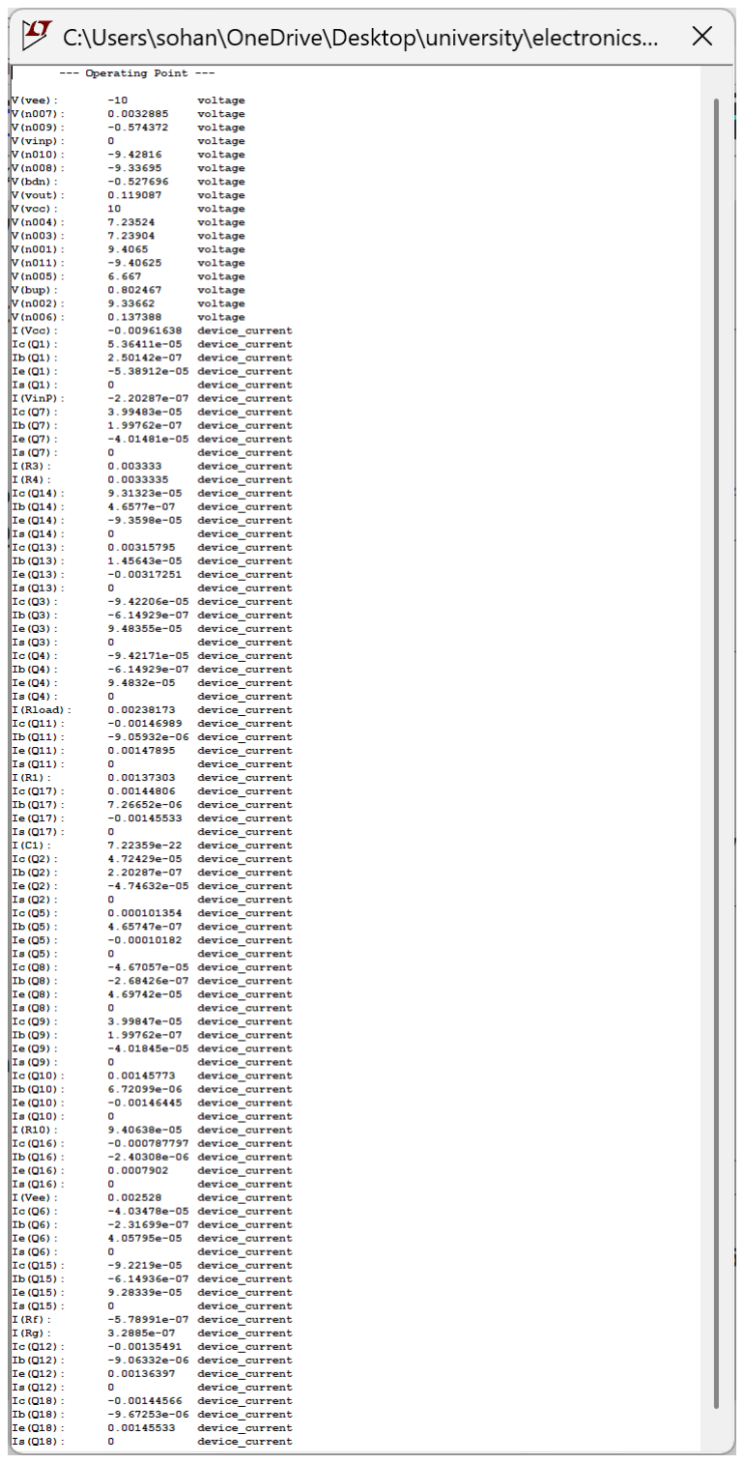
[picture p17: figure]

Figure 22 – Operating-point result with zero input, showing V (vout) = 0.119087V .

## 16 Submitted Files

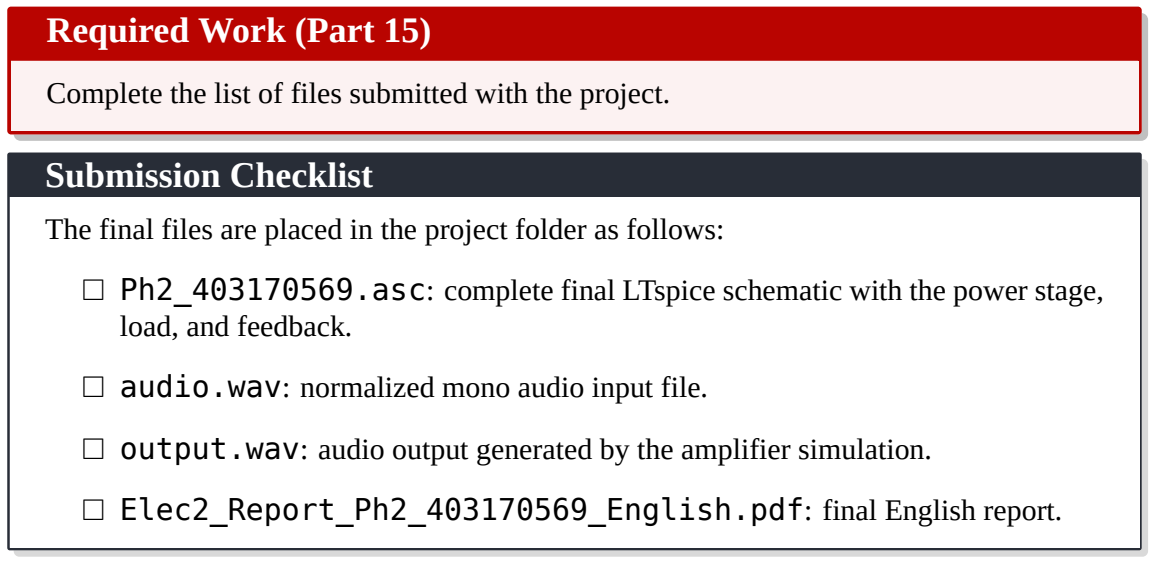
[picture p18: figure]
Required Work (Part 15); Submission Checklist; load, and feedback.; □ Elec2_Report_Ph2_403170569_English.pdf: final English report.

Complete the list of files submitted with the project.

The final files are placed in the project folder as follows:

□ Ph2_403170569.asc: complete final LTspice schematic with the power stage,

□ audio.wav: normalized mono audio input file.

□ output.wav: audio output generated by the amplifier simulation.

## 17 Final Conclusion

### Required Work (Part 16)

Briefly discuss the main Phase-II design challenge, the most difficult part among the output stage, feedback, THD, PSRR, and audio tests, any unmet specifications, and possible improvements if additional time or cost were available.

### Conclusion

The central Phase-II challenge was balancing output swing, efficiency, loop stability, and distortion. Simply adding a push-pull stage to the voltage amplifier was not sufficient: incorrect biasing could produce crossover distortion, while the large loop gain could make the amplifier susceptible to oscillation or undesirable transient behavior. Adjustment of the Q17–Q18 bias network and selection of the C1 = 82pF Miller capacitor were decisive in obtaining a stable response and low THD.
The most difficult task was simultaneous optimization of noisy THD and stability. Increasing the compensation capacitor reduced high-frequency content and improved the noisy THD result, but it was necessary to verify that gain, swing, efficiency, bandwidth, and slew rate remained acceptable. The PSRR test also required a careful peak-to-peak ripple definition and correct base-10 logarithm calculation.
The final circuit satisfies all mandatory specifications: gain 20.877, swing 16.05Vpp, output-stage efficiency 63.33%, standard-condition power 163.76mW, normal THD 0.0404%, noisy THD 0.819%, input resistance 32.48MΩ, and output resistance 0.214Ω. With additional time and component budget, complementary power transistors with better matching, small emitter resistors for thermal stabilization, a more accurate current source, and an output-offset adjustment circuit could improve symmetry and efficiency. A full AC phase-margin analysis and Monte Carlo simulations for β and temperature variations would further strengthen confidence in the design.
