SohaNiroomand/Discrete-BJT-Audio-Power-Amplifier/Ph2_403170569.asc

C1: cap; 82p
Q1: npn; mynpn
Q2: npn; mynpn
Q3: pnp; mypnp
Q4: pnp; mypnp
Q5: npn; mynpn
Q6: pnp; mypnp
Q7: npn; mynpn
Q8: pnp; mypnp
Q9: npn; mynpn
Q10: npn; mynpn
Q11: pnp; mypnp
Q12: pnp; mypnp
Q13: npn; mynpn
Q14: npn; mynpn
Q15: pnp; mypnp
Q16: pnp; mypnpn
Q17: npn; mynpn
Q18: pnp; mypnp
R1: res; 6.8k
R3: res; 1k
R4: res; 2k
R10: res; 200k
Rf: res; 200k
Rg: res; 10k
Rload: res; 50
Vcc: voltage; 10
Vee: voltage; -10
VinP: voltage; SINE(0 50m 1k)
Named nets: 0, VinP, Vout, Vcc, Vee, BUP, BDN
.param L = 0.18u
.model mynmos NMOS(Kp=250u vto=0.6 lambda=0.05 W={100*L} L={L} gamma=0 phi=0)
.model mypmos PMOS(Kp=80u vto=-0.6 lambda=0.05 W={50*L} L={L} gamma=0 phi=0)
.model mypnp AKO: 2N3906 (bf=150)
.model mynpn AKO: 2N3904 (bf=200)
.model mypnpn AKO: 2N3906 (bf=300)
